VAleSh-Soft/tda7339_to_tda7439/docs/VTCD-800_s_m.pdf

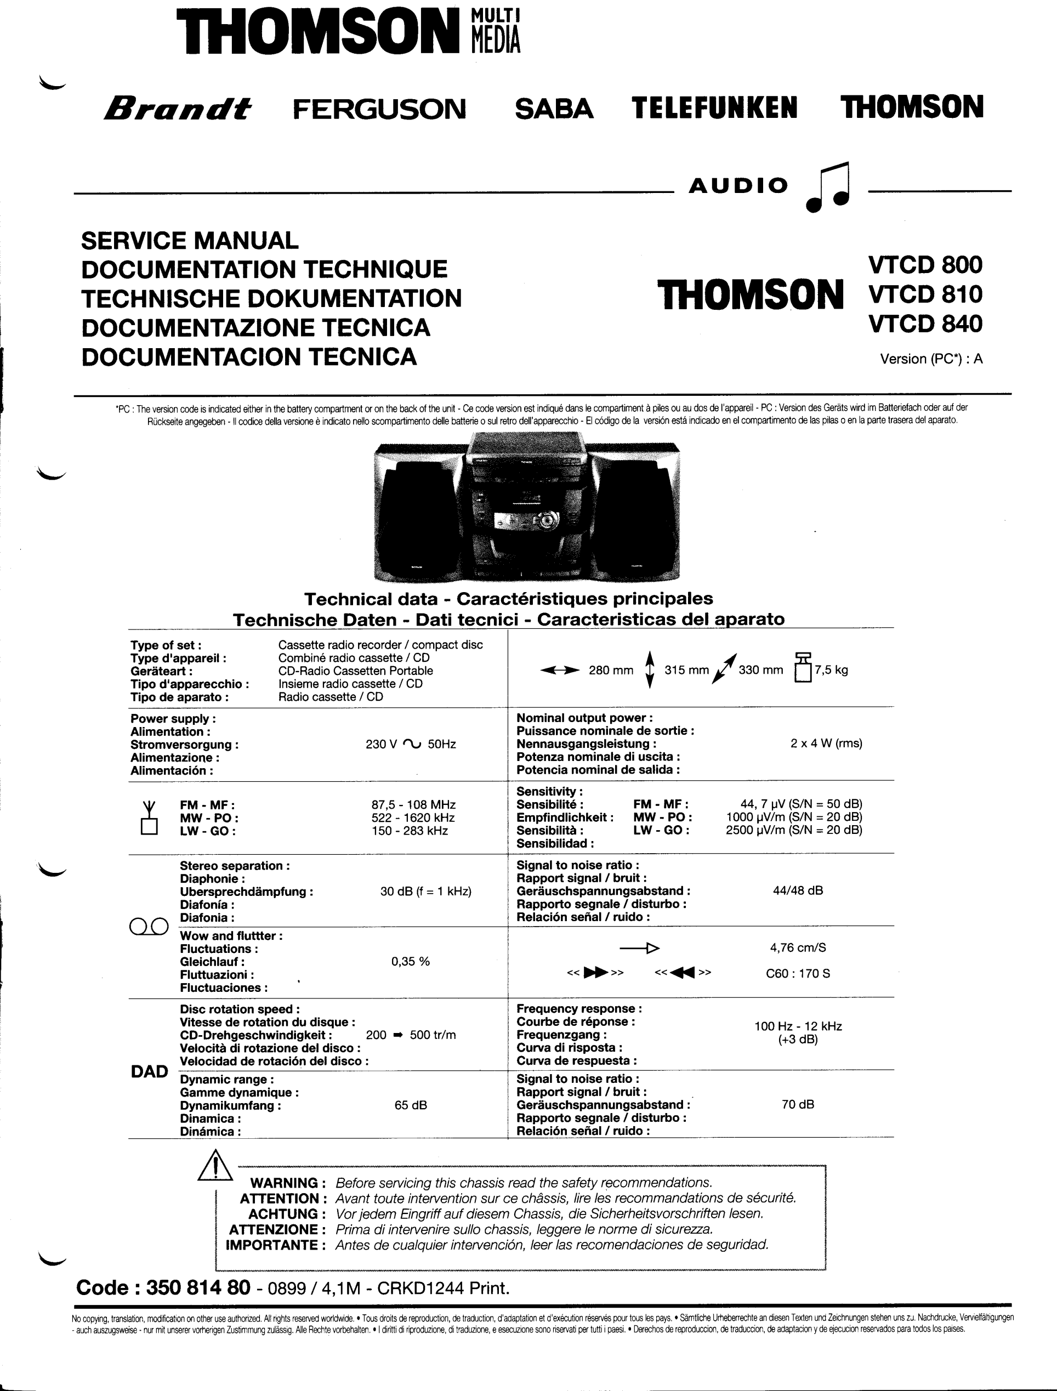
[picture p11: page 1]

# MAIN SCHEMATIC DIAGRAM - SCHEMA DE LA PLATINE PRINCIPALE - SCHALTBILD HAUPTLEITERPU ESQUEMA DE LA PLATINA PRINCIPAL

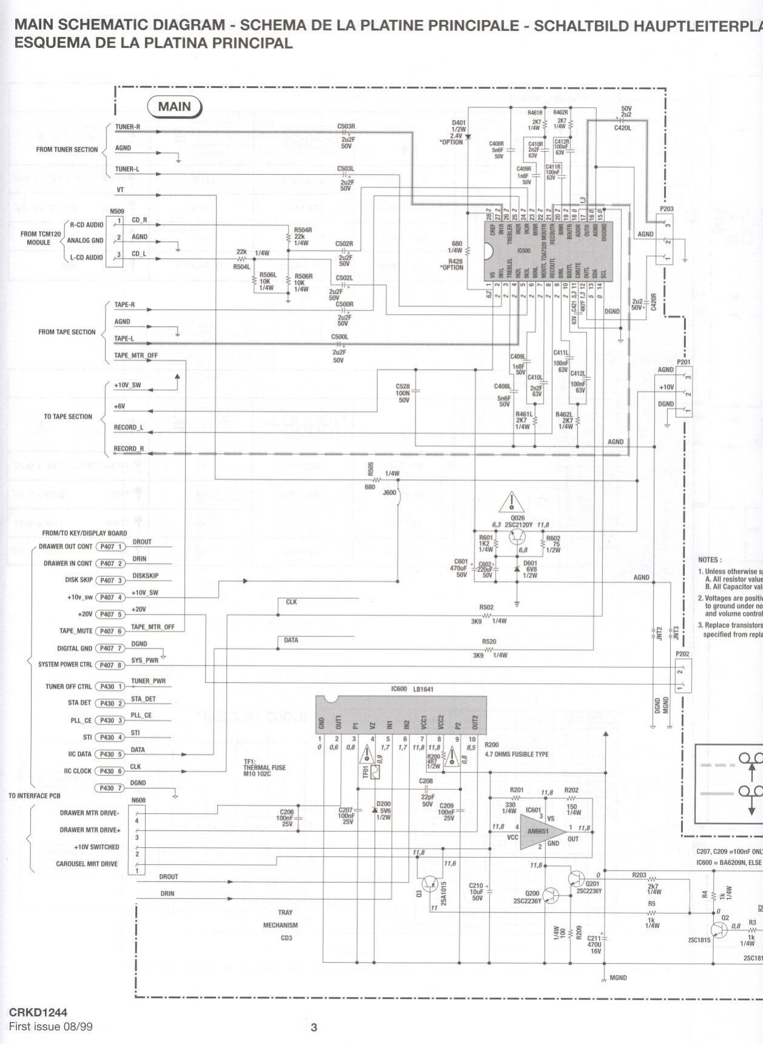
[picture p12: page 2]

'-':'-', I | ~'"- | . I

_
I
( MAlN ) | 0401 | 1/~~ | 1/~~ | C420L | -
C R | 1/2W | I 2.4V | -
{
TUNER.R | 2u2F | 'OPTION | C4()8R
I SOV | 5n6F
5OV | . FROMTUNERSECTlON | AGNO | . 1 | 1 - | ~a | -
TUNER.L | . | ~U2F | I VT | SOV
{
R'COAUUlO
FROMTCM120
MOOULE ANALOGGNO

L-COAUUlO

N509
11 CO_R

AGNO

CO_L

FROM TAPE SECTION
{

TAPE.R

AGNO

TAPE-L

TAPE_MTR~FF

(

+10VSW - | . +6V TO TAPE SECTlON

RECORD_L

RECORI!~R

FROMITO KEYIUlSPLAY BOARD
DRAWEROUTCONT~

DRAWERIN CONT~

UlSKSKIP ~ +10v_sw ( P407 4) +10V_SW

+20V (P407 S +20V

TAPE_MUTE( P407 6) TAPE_MTR_OFF UlGITALGND~ SYSTEMPOWERCTRL( P407 8) SYS]WR

TUNEROFFCTRL( P430 1) TUNER]WR

STADET ( P430 2) STA_DET
PLL_CE~

STI~
IICDATA( P430S~A
IIC CLDCK( P430 6~
~ TOINTERFACEPC8 | - N608 | .&

{

DRAWERMTRDRIVE.

ORAWERMTRDRIVE+

+10VSWITCHED

CAROUSELMRTDRIVE

660
1/4W
R428 'DPTION

DGND

I

.. 1

2u2-l-re - sov+r3 I

'-'1

1

I
P201
AGND

~
~

1

2U2F
SOV

CSOOL

00
ZZ

""" o,,"

R203
-m- 2k7
1I4W
RS

1k
1I4W

MGND

,-.-.-.-.-

C207, C209 =1 oonF ON~
IC600 = BA6209N, ELSE

~ ;: ~~

2u2F
SOV
j | CS28
1ooN
SOV | Sn6F
SOV

N

1k 1I4W

2SC181

## CRKD1244 First issue 08/99

R461L 2K7 : 1I4W'

R462L 2K7
1/4W

'"
"
~ | 1I4W
680 J600 | &0026

6,3 2SC2120Y11,8
R601 | fi | 602 1K2 | 7S 1/4W | 6.8 | 1/2W
C601 +1 C60~,-- 470uF | 'f22~ilÍt s8vT

### SOV~

0601
6V8
1I2W
CLK | RSO2
| 3K9 1I4W
DATA | RS20 -.f#--- 3K9 1/4W

TF1:
THERMALFUSE M10 102C
11,8 | R202
IC600 | L81641

R2oo

4.7 OHMS FUSI8LE TYPE

C2OS
R201

C206
100nF- 2SV

C207'
100nF
2SV

D2oo
,SV6
1I2W

22pF
SOV C209
1OOnF 2SV

1S0
1/4W

11,6
DROUT
C210 +
10uF
SOV ORIN

TRAY
MECHANISM
C03
1 AGND j I | 1

I
I
1
I
I

1 NOTES:

AGNDI | 1 1.Unlessolherwlse SI A.Aliresislor value I B.AliCapacilor vali

I 2. Vollages are posilh
lo ground under no
and volume conlrol
N | ),M 1 | 3. Replace Iransislors
X"" X"" - | specified from repla
.;; | y;; I
| P202

RS04R
22k
1I4W CS02R
22k 1/4W

RS06L t RS06R
10K | 10K 1/4W | 1/4W

# LTBILDHAUPTLEITERPLATTE - SCHEMA PIASTRA PRINCIPALE-

1--'-'-'-"'"

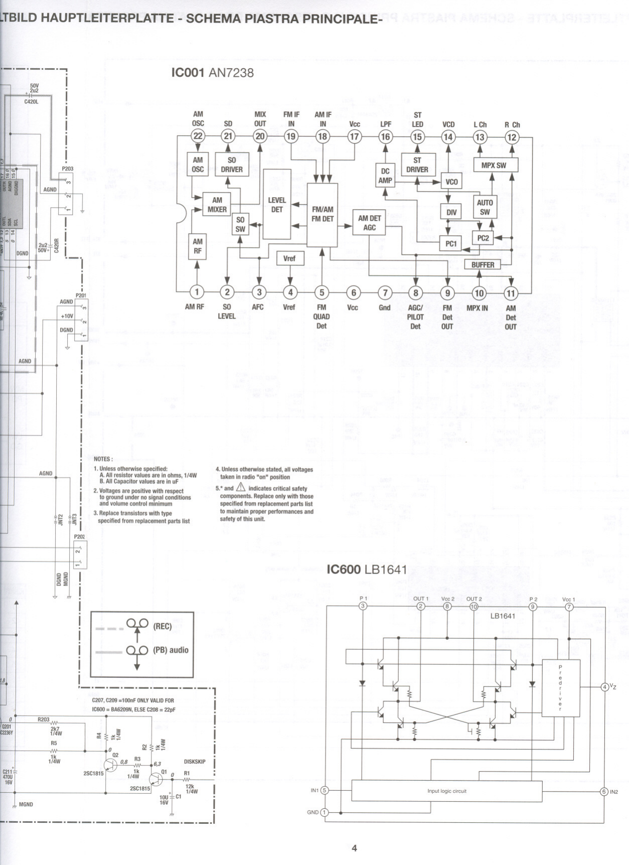
[picture p13: page 3]

I

1
I
I

1
I

50V
2u2 "'!~

C420L

# ICOO1AN7238

I
P201
AGNO
'<O1R101- | I | 12k ~ | êL | 1 1I4W 1011 C1 | . MGNO | 16VI !

:>1"'1<>
~ DGNO
/
íI

I
AGNO

~

o Vâ1Ot

~2236Y

C211~
47DII
16V

I

. 1'" I 2u2 ~ - 50V.;["C$ 1

'-',

1

AGNO

R203
--vvv2k7

1I4W
R5

1k
1I4W

AMRF SO
LEVEL
AFC | Vref | FM
QUAD
DeI
Vcc | Gnd | AGC!
PILOT
DeI

FM
Det
OUT

MPXIN AM
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
~'" ÀM I
X~ ~~ i
| P202

NOTES:
I, Unlessolherwisespecilied: A.Aliresislorvaluesarein ohmso1I4W B.Ali Capacilorvaluesarein uF 2.Vollagesareposilivewilh respecl
lo groundundernosignalcondilions andvolumeconlrolminimum

3,ReplaceIransislorswilh type speciliedIromreplacemenlparIslisl

4.Unlessolherwiseslaledoali voltages laken in radio"on" posilion
6,* and .6 indicales crilical salety

components.Replaceonlvwilh Ihose specifiedIrom replacemenlparIslisl lo mainlainproporpertormancesand salety01Ihis unil.

CC
ZZ """

c:; I
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
OISKSKIP I RI

# IC600 LB1641

P 1
'3i

P2
9)

Vcc 1
'7
LB1641

## ar(REG)

ar(PB) audio

4jVz

C207, C209 =100nF ONLY VALlO FOR

IC600 = BA6209N, ELSE C2OS = 22pF

;::
~! | ;::
~ ~~!
Inputlogic | circui! | 6) IN2

# MAIN SCHEMATIC DIAGRAM - SCHEMA DE LA PLATINE PRINCIPALE - SCHALTBILD HAUPTLEITERPL (TUNER PART)

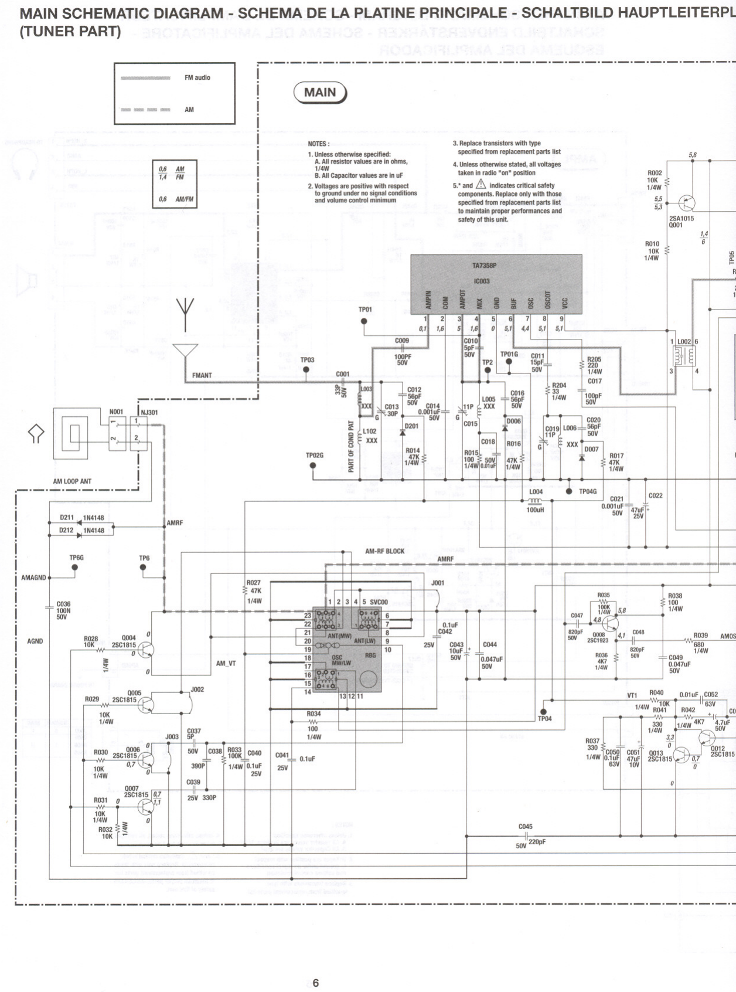
[picture p14: page 4]

«

----- FMaudio

AM

0,6 AM
1;4 FM

0,6 AMIFM
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
~ | ~
INJ301
f

0211
0212

1N4148
1N4148

AMRF

o

RO29

AM_VT

# ( MAIN )

NOTES:
1. Unless olherwise specilied:
A. Ali resislor values are in ohms, 1I4W
B. Ali Capacilor values are in uF
2. Vollages are posilive wilh respecl lo ground under no slgnal condilions and volume conlrol minimum
3. Replace Iransislors wilh type specilied lrom replacemenl paris lisl
4. Unless olherwise staled, ali vollages laken in radio "on" posilion
5.' and ,1; indicales crilical salety componenls. Replace only wilh Ihose specilied Irom replacemenl paris list lo mainlain propor perlormances and safety 01Ihis unil.

R205
220
1I4W
CO17

1~~t

C020
S6pF
SOV
XXX T0007

5,8

RO02
10K
1I4W
5,5
5;3
2SA101S
0001

R010
10K
1I4W

M6
"'
~
I-
RI
,
1,

RO17
47K
1I4W

LOO4
TP04G J C0211 1 C022 0.001uFI47uFT+

SOVI"2SV

ROAO
VT~1/4W R041

0.01uFI

~
COS2
63V
~ | tO!

1/~W j1l4W4K,~ ~~.JF
3,3
O- R037
33°i'COSO

I

cosiI ⁰⁰¹³ 1I4W10.1uF 47uF 2SC181S 63V 10V

TP6G | TP6 I
AMLOOPANT | ! .-,-,-,-,-,-,-,...1
I
I
I
I
I

iAMAGNO
I
I
I
i AGNO
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
CO36
100N
SOV

R028

10K | 0004 2SC181S
| li
!

10K
1/4W

R030 2S 0006 O
~10K | 0,7 1I4W | -O

0007
2SC181S10,7
JJ R031
-IW-10K
1I4W
R032

10K !

C037
~ | RO33 CO40 5OV C038 100K.r
WTo.1uF 390Pr | 1/4 | 2SV
C039

2SV 330P

O

TP03

TP02G

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
1I4W

L102
XXX

0201

R014
47K
1I4W

100uH

AM-RF BLOCK
AMRF

R027
: 47K

1I4W

TPOA

JO01

0.1uF
C0A2
2SV | CO44 f8:~ 1+ SOV | 0.047uF

SOV

R034
-w.-
100
1I4W

C041
2SV

0.1uF

COAS

SOV220pF

# MAIN SCHEMATIC DIAGRAM - SCHEMA DE LA PLATINE PRINCIPALE - SCHALTBILD HAUPTLEITERPL (TUNER PART)

«

----- FMaudio

AM

0,6 AM
1;4 FM

0,6 AMIFM
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
~ | ~
INJ301
f

0211
0212

1N4148
1N4148

AMRF

o

RO29

AM_VT

# ( MAIN )

NOTES:
1. Unless olherwise specilied:
A. Ali resislor values are in ohms, 1I4W
B. Ali Capacilor values are in uF
2. Vollages are posilive wilh respecl lo ground under no slgnal condilions and volume conlrol minimum
3. Replace Iransislors wilh type specilied lrom replacemenl paris lisl
4. Unless olherwise staled, ali vollages laken in radio "on" posilion
5.' and ,1; indicales crilical salety componenls. Replace only wilh Ihose specilied Irom replacemenl paris list lo mainlain propor perlormances and safety 01Ihis unil.

R205
220
1I4W
CO17

1~~t

C020
S6pF
SOV
XXX T0007

5,8

RO02
10K
1I4W
5,5
5;3
2SA101S
0001

R010
10K
1I4W

M6
"'
~
I-
RI
,
1,

RO17
47K
1I4W

LOO4
TP04G J C0211 1 C022 0.001uFI47uFT+

SOVI"2SV

ROAO
VT~1/4W R041

0.01uFI

~
COS2
63V
~ | tO!

1/~W j1l4W4K,~ ~~.JF
3,3
O- R037
33°i'COSO

I

cosiI ⁰⁰¹³ 1I4W10.1uF 47uF 2SC181S 63V 10V

TP6G | TP6 I
AMLOOPANT | ! .-,-,-,-,-,-,-,...1
I
I
I
I
I

iAMAGNO
I
I
I
i AGNO
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
CO36
100N
SOV

R028

10K | 0004 2SC181S
| li
!

10K
1/4W

R030 2S 0006 O
~10K | 0,7 1I4W | -O

0007
2SC181S10,7
JJ R031
-IW-10K
1I4W
R032

10K !

C037
~ | RO33 CO40 5OV C038 100K.r
WTo.1uF 390Pr | 1/4 | 2SV
C039

2SV 330P

O

TP03

TP02G

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
1I4W

L102
XXX

0201

R014
47K
1I4W

100uH

AM-RF BLOCK
AMRF

R027
: 47K

1I4W

TPOA

JO01

0.1uF
C0A2
2SV | CO44 f8:~ 1+ SOV | 0.047uF

SOV

R034
-w.-
100
1I4W

C041
2SV

0.1uF

COAS

SOV220pF

# ~LTBILD HAUPTLEITERPLATTE - SCHEMA PIASTRA PRINCIPALE - ESQUEMA DE LA PLATINA PRINCIPAL

..- | 1. 6v

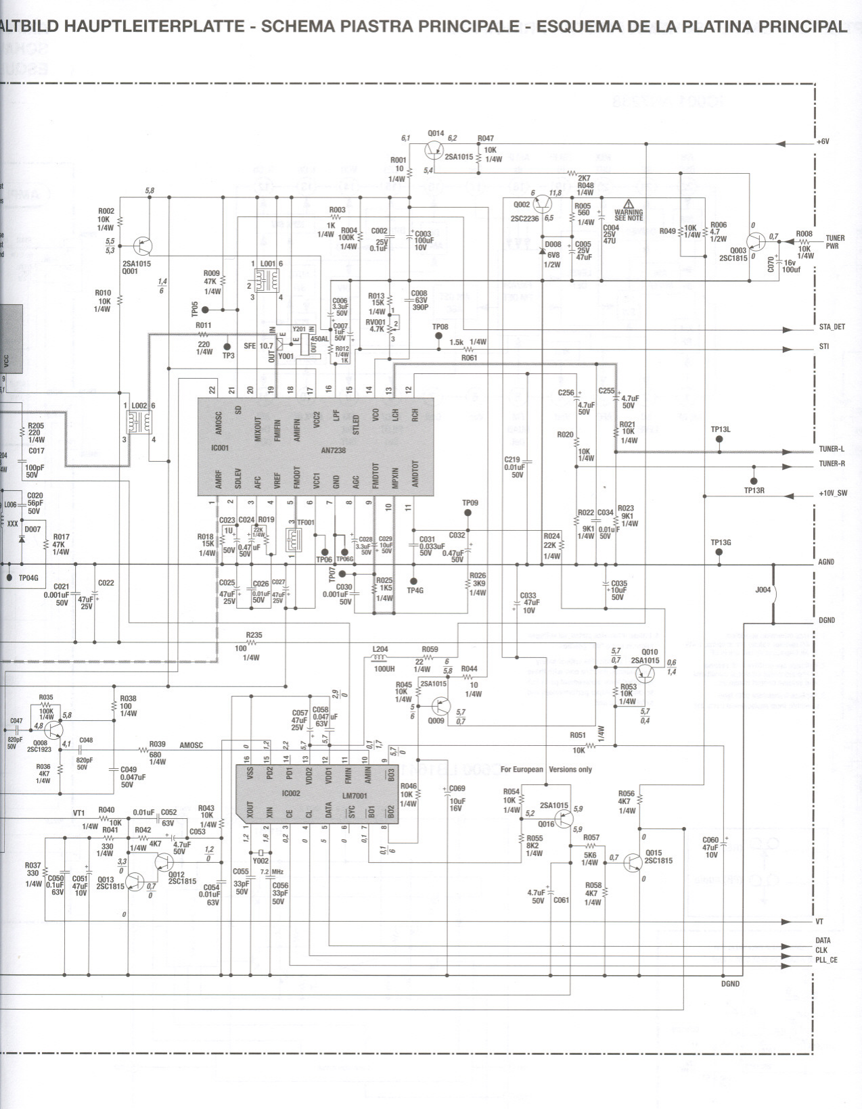
[picture p15: page 6]

~
F

5,8

RO03
-'Mr-1K RO04 1I4W1ooK
1I4W

~
"
~

R002
10K
11-;1 d
5,3~
2SA1015
0001 | RO09
47K:
1/4W

1 LO0116

2 | Ilê
3 | 4 R010
10K
1/4W

1,4
li
f~....
R011
220 . 1/4W TP3
~ | N ~ | :2 :: !---
11~6

~II~
3114

R205
220
1I4W

!04 ..L CO17

~W T1~~F

---<

r l C020

.llOO6..l56pF
T50V
XXXt;;;-;
- N | '" | .. | ..,
,
| | | .'TFO01
~II | ; 33uF

# - Jll~ RO17

47K
1I4W

1 ;P04GJ C0211 1 C022

0.001 uF 147uFT+
50V 1"25V
~... C0251 ~026 CO27tLI:=C03~ 47uF+ O.O'uF07uF+ | 0.001uFT 25V | 50V 25V | 50V1

R235
---wv-100
1/4W

*C0490.047uF
50V

R039
6ãO
1I4W | ~

RO38
100
1I4W | C057

I

C058

1

47uF 0.047uF 25V 63V

## AMOSC '" ~::f~)'~ :2 :2 ;! ~

r

VT1 R040 | 0.01uF C052
10K | 63V | _
14

M

1/4WR041 | R042 | " '" " 330 | 1/4W4K7 4.7.}'F 1,2 | -' | ~ | '"
1/4W | 50 | O' | VO02
32 | C055 7.2MHl O | 0012
~ ⁰⁰¹³ | 2SC1815 C05

~ 33P
T

C056
2SC1815 | 0.01uF | 50V | 33pF
63V | 50V

'"

.. "'
'"

R037

~

..l , 330 COSO C05i 1I4W 0.1uf 47uF 63;;1 10V

o

6,1 | R047
10K
RO01I | 1I4W
10 } 1I4W | 2K7
RO48
1I4W
ROO5
560 +
1/4W
R049~1Y:W | TUNER
PWR

6 11,8
00O2iGt'
2SC22~5
Coo~
25V1
0.1ufl

&.
~AR~b~~
> | 1 | I

CO04

,0008 1CO05 ~~H
6V8 T²⁵V
1/2W 47uF

~

RO06 | O
1i1w | 0,7 | RO08
0003 | 10K 2SC1815O ",+ | 1I4W
8T11J~uf | :
I
I

## ISTUET

+CO03
100uF
10V

Rf~~
~

### JEg~

1I4W 1 T390P
RVO01 2 4.7K

3

TPO8

~4W | RD61 | I
I
I
I
I
TUNER-L

STI

~ | ~ | ;! | ~ | C2561+

I

C255i.
, | :f4.7UF
4.7uF | S 50V 50V

R020

+ R021
10K
1I4W

TP13L
, C219-"-- 0.O1uF' 50V

10K
1/4W | TUNER-R
TP13R | +10V_SW .... | TP09 | ...-- ao | :: | _R022IC034

~

R023

::.J.: | 9K1
9K1Tõ.O1u F 1/4W
1I4W!SOV | TP13G
!

I
I
I

AGND

--LC031 C032 -.O.033uF 1+ 50V 0.47uF' 50V

R024
22K:
1/4W

TP4G

R026
:3K9
1/4W | JoJ

I
I

I DGND

C035
+10uF CO33 | 50V 47uF +1 10V | í L204

22d6

1I4W 5]j R044
R045 2SA101S | 10
10K | 1I4W 1I4W
~ | 5,7
6 | 0009 OJ
~

100UH

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
~I",

:: J1~F'"

R046n
~

+ CD69
10K | T10UF 1/4W | 16V

R051
10K
For Europa." I Varsio". | o"IV
'" | 00

R054

10K'f | 2SA1015 59 1I4WI5,2 | '
0016
R055
8K2 | 0015 1I4W | 2SC1815
R058 4.7uF+.L | I
4K7: 50VTC061 | 1I4W

CO60 1+
47uF
10V

R056
4K7
1I4W
'" ;;,
;;-1«>

DAr.
CLK
PLL_CE
I
I
I

DGNO

# ~PRINCIPAL

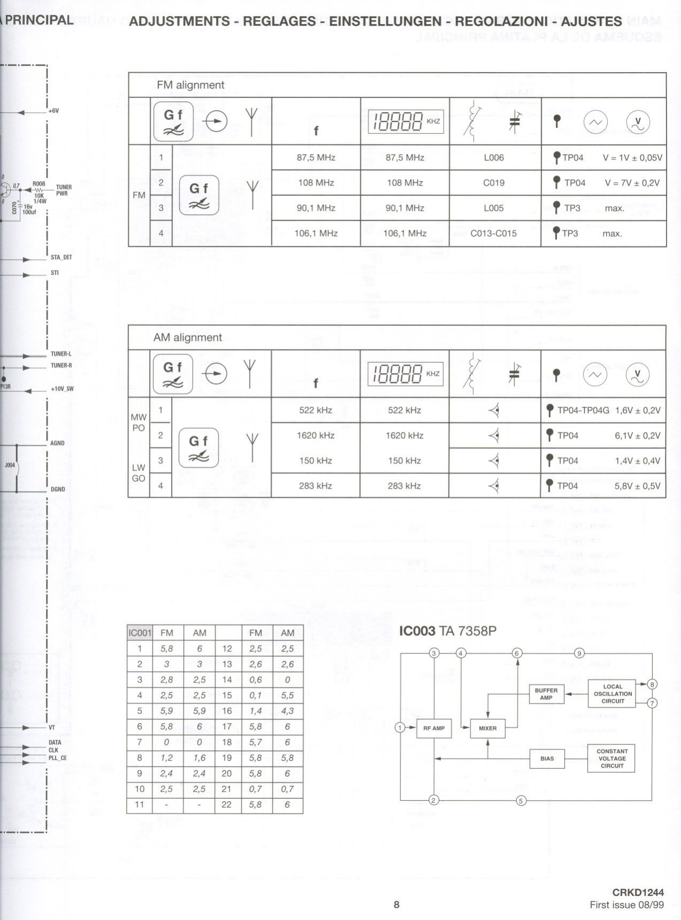
[picture p16: page 7]

I
I
I
+6V

RODa TUNER
PWR

# . ISTA_DET

# . STI

-+

I
I
I
I
I

.TUNER.L

TUNER.R

~

P13R .. +1UV_5W
I
I
TI | : AGND
JOO4 | .
I
| I DGND

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
. DATA
CLK
PLL_CE
I
I
I
I .-.

# ADJUSTMENTS - REGLAGES- EINSTELLUNGEN - REGOLAZIONI - AJUSTES

# ICOO3TA 7358P

9

2 | 5

## CRKD1244

## First issue 08/99

# FMalignment

[JB r | f | I"IC/C/C/C/ /I/IIn KHZ I

f #

'
G (1)
1 | 87,5 MHz | 87,5 MHz | LO06 | 'TP04 | V = 1V :J: 0,05V -

2
(] | r
| 108 MHz | 108 MHz | C019 | 'TP04 | V = 7V :J:0,2V
FM -
3 | 90,1 MHz | 90,1 MHz | LO05 | 'TP3 | max.
4 | 106,1 MHz | 106,1 MHz | C013-C015 | 'TP3 | max.

## AM alignment

[]-8 | r | f | I'' IC/UUU IUUU KHZI
k #

'
G (1)
1 | 522 kHz | 522 kHz | -<i MW | 'TP04-TP04G | 1,6V:J:0,2V
PO -
2
[] | r
1620kHz | 1620kHz | -<i | , TP04 | 6,1V:J:0,2V -
3 | 150 kHz | 150 kHz | -<i | 'TP04 | 1,4V :J:O,4V LW
GO -
4 | 283 kHz | 283 kHz | -<i | 'TP04 | 5,8V :J:0,5V
;t() | FM | AM | | FM | AM
1 | 5,8 | 6 | 12 | 2,5 | 2,5
2 | 3 | 3 | 13 | 2,6 | 2,6
3 | 2,8 | 2,5 | 14 | 0,6 | o
4 | 2,5 | 2,5 | 15 | 0,1 | 5,5
5 | 5,9 | 5,9 | 16 | 1,4 | 4,3
6 | 5,8 | 6 | 17 | 5,8 | 6
7 | o | o | 18 | 5,7 | 6
8 | 1,2 | 1,6 | 19 | 5,8 | 5,8
9 | 2,4 | 2,4 | 20 | 5,8 | 6
10 | 2,5 | 2,5 | 21 | 0,7 | 0,7
11 | - | - | 22 | 5,8 | 6

## MAIN SCHEMATIC DIAGRAM - SCHEMA DE LA PLATINE PRINCIPALE - SCHALTBILD HAUPTLEITERPLAT

## (TAPE PART)

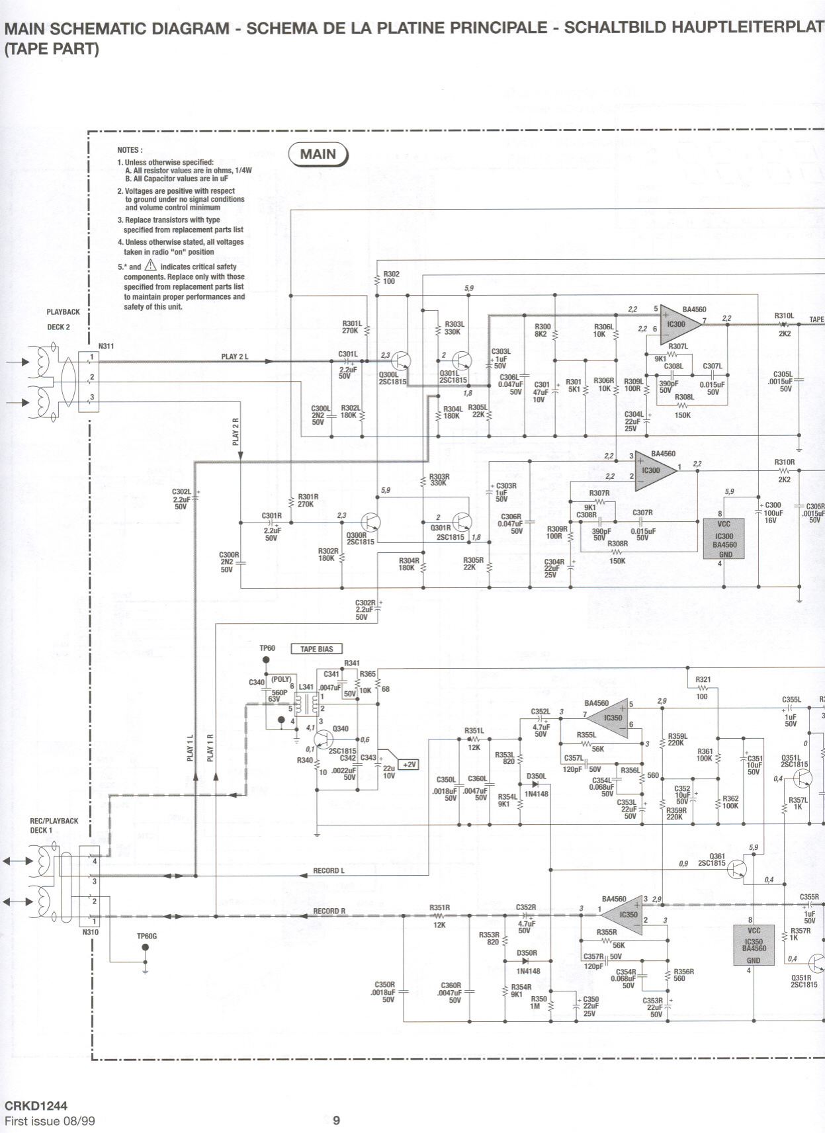
[picture p17: page 8]

NOTES:

1. Unless olherwise specilied:
A. Ali resislor values are in ohms, 1/4W
B. Ali Capacilor values are in uF
2. Vollages are positive wilh respecl
lo ground under no signal condilions and volume conlrol minimum

# ( MAIN)

I
I

# L._._._.-.-.-.-.-.-.-.-.-.-.-.-.-.-.-.-.-.-.-.-.-.-.-.-.-.-.-.-.-.-.-.-.-.-.-

## CRKD1244

First issue 08/99 | 9

R302
100
5,9
22 | BA4S60 | R310l >--
"7 | 2, | TAPE R301l | R303l | R300 | R306l | 2,2 6 | 2K2 270K | 330K | 8K2 | 10K
C301l | C303l | .07l 2,3
9K1 | 1
"I Á | .--, | PLAY2 l | luF
Q30;;0 | Cp8l | C3,97l SOV
.08fg==
\ | 2.2uF | C306l= | R306R R309l

lijO;F

0.015UF

SOV
+ R;11
2 | 2SC181 | 2SC181S | 0.047uF C301 | 10K | I00R | SOV | SOV 1,8 | SOV 47uF | R308l / | 3 | 10V
R302l | R304l R30Sl | C304l + | IS0K C300l v
3= = 180K | 180K 22K o: | 22uF
2SV I | N
5... I | 2,2 | 3 | BA4560
R310R 1 2,2 I | R303R | 2,2 2 | 2K2 330K | +C303R
I | C302l | 5,9 | luF | R307R R301R

2J

### SOV

+ F =

:=C30SR

2.2uF | 270K | 9K1
Cp7R | .001SuF I | 5OV
2,3 rv | C306R | C308R | 16V | SOV C301R
0.047uF I | 2.2F | O.O'SuF

Q3o.t:l

Q301 | SOV | R309R
2SC1815 1,8 | 100R | 390,pF
50 R308R 50V | 50V 2SC1815 I | R302R
150K C300R | 180K
l8:R i< | R305R | C304R + I | 2N2 *= | 22K | 22uF

50V I

25V
I
I | C302R+ 2.2uF

50V I

I | TP60 I TAPEBIAS I
I | 4 | R341

C340 (POiY)
C3:t
R365 I | ==, 6 | .0047uF 10K 68
100 I | C355l | R:
6euP5 II

1 50V
: | " | +luF
2 | C352l 3 | 3
50V I | 3
4,1 | ÚF R351l | 50V | R355l | R359l I | 3 | 220K | O .... o: | 0,6 | 12K | 56K | R361
+C351 Q351l 5 5 | 0,1 2SC1815 | R353l I | C342C343 | 820 | C357':JL | I00K | 10uF | 2 ... ... | R340

10 .OO22uF
120pF "50V | L
50V 0350l | 560 I | D.4 ⁵⁰V | 10V | C350l | C360 1=

148

C354l
.0018uF | 0.068uF | C352 0047UF | " R354l | 50V | \'if; + | R362 | R357l I | 50V | 50V | C353l + | 100K | IK

1

9K1 | 22uF | R359R I | 50V | 220K EC/PLAYBACK
I ECKI | - | 5,9
Q36 4 | 0,9 2SC1815
RECOROl
3 | 0,4
' r- | C355R
:.51R | C352R | 3 RECOROR | luF
2 | 3 | 8 | 50V 12K | 4.7uF | R357R
1
50V | R355R | IK
-=:: | TP80G | R353R
820 | 56K
Li | 0350R | C357R"50V
IN4148 | 120pF" C354l | R356R | 4 560 | Q351R C350R | C360R | O.068UrL | 2SC1815 i<R354R | 50V
.0018uF =r= | .0047uF =r= | 9K1 R3500 C350 | C353R 50V | 50V | + IM
T22uF | 22uF 25V | 50V

# ICHALTBILDHAUPTLEITERPLATTE - SCHEMA PIASTRA PRINCIPALE - ESQUEMA DE LA PLATINA PRINCIPA

I

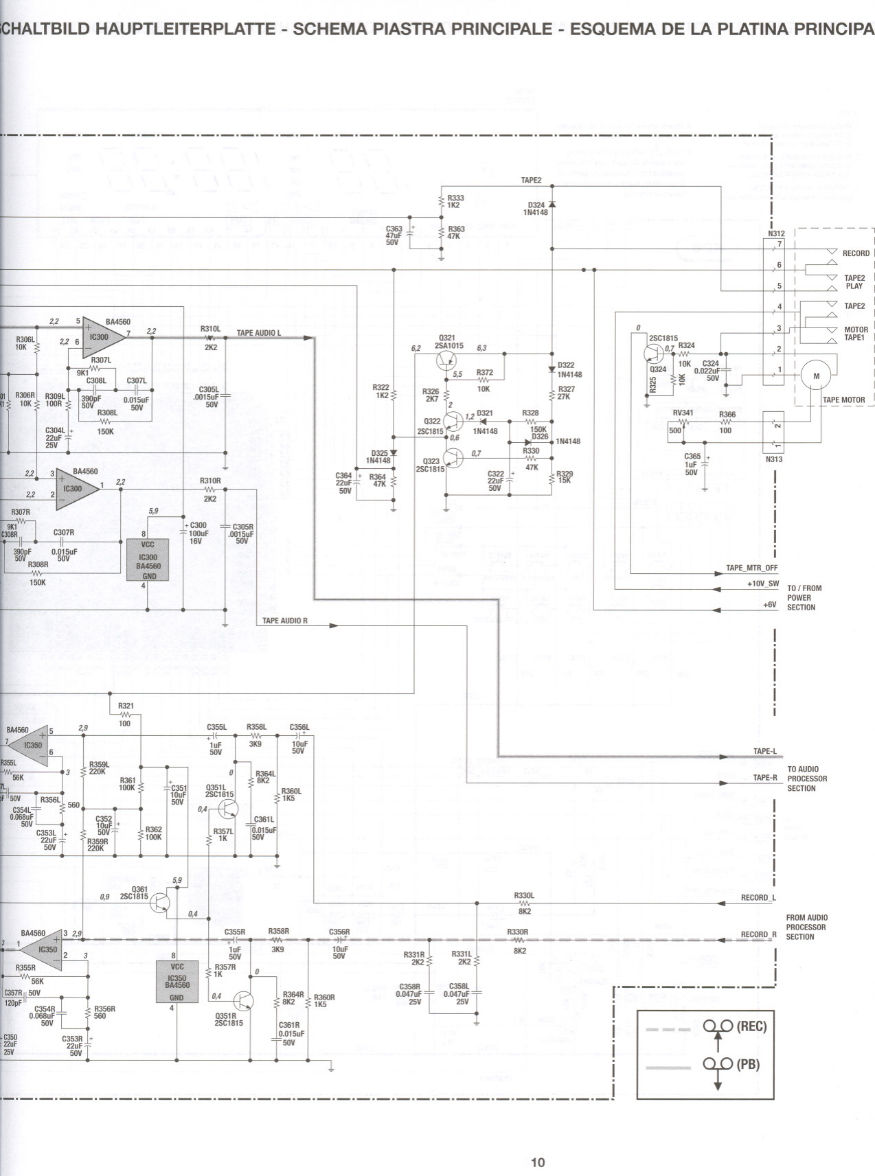
[picture p18: page 9]

~

I
I
,'-'-'-'-'-'-'-'-'
I
I
I
I

R333
1K2

C363 1+ 47uF
50V

R363
47K

R306L
10K

2,2

~ I R306RI R309L
I1$ | 10K$ 100R
C304L | 1+
22uF
25V

150K

2,2 | 8A4560
1 | 2,2
2,2
~ ~.
~~O7R
nqyF o.ot; 50 R308R 5OV

150K

TAPE | AUDlO | R

~64R~ ~~~OR

C358R..l C358L-0.047UFT 0.04J~~T
25V=

10uF

50V 3K9 | R331R 2K2 | R331L
2K2

C354R
O.068uF 50V

R356R
560 | 0351R
2SC1815 | C361R
O.015uF
-50V ~C350
i 22uF
25V

C353R 1+
22uF
50V

TAPE2

0324
1N4148

R330L
--'Wv--
8K2

R330R

8K2

~
1;1

I
I
I
~312 I | l
71 I | I RECORO I

I
TAPE2I
PLAY I
TAPE2I
I
MOTORI
TAPE1I
I
I
I
I
I
RV341 R366
-0N-100

N313

TAPE_MTR_OFF

+10V_SW TO/FROM
POWER
+6V SECTION

TAPE-L"

TO AUDlO

TAPE-R | PROCESSaR SECTION

RECORO_L

FROM AUOIO

PROCESSaR

RECORO_R | SECTION

# ar (REG)

~ (PB)

2,_2 | R310L
Wi- r.HIPIAUDlO,L "'; | I
0321
2K2 | 62 | 2SA1015
-------,
0322

C305L..l
I R326 rv

1N4148
.0018T | I | R322f ¹K2 | R327
2K7 | 27K
2 | R328
-wr---- 150K

1N4148
| | | 0325 | | R330
| | | 1N4148
I | 0323 R310R | C364 | R364 | 2SC1815 | 47K
I

R329
| | 8T | 47K

15K
2K2
5

+ C300
T C305R
100uF | .OO15uF
16V | 50V

R321
-wv-
2,9 | 100 I | C355L R358L C356L
-------.1 | 1uF | 3K9 | 10uF 50V | 50V

R359L 220K
J f3641
R361 | 8K2 R360L 100K | 0351L 2SC1815 | 1K5

C352

lR;1 | ..lC361 L I
10uF + | R362
1.015uF 50V
R359R | 100K | 50V
220K

5,9
0361
0,9 2SC1815
C355R | R358R | C356R+

# OUDISPLAYSCHEMATICDIAGRAM- SCHEMACOMMANDES/AFFICHEUR- SCHALTBILDBEDIENTEIL/ANZEIGE

I

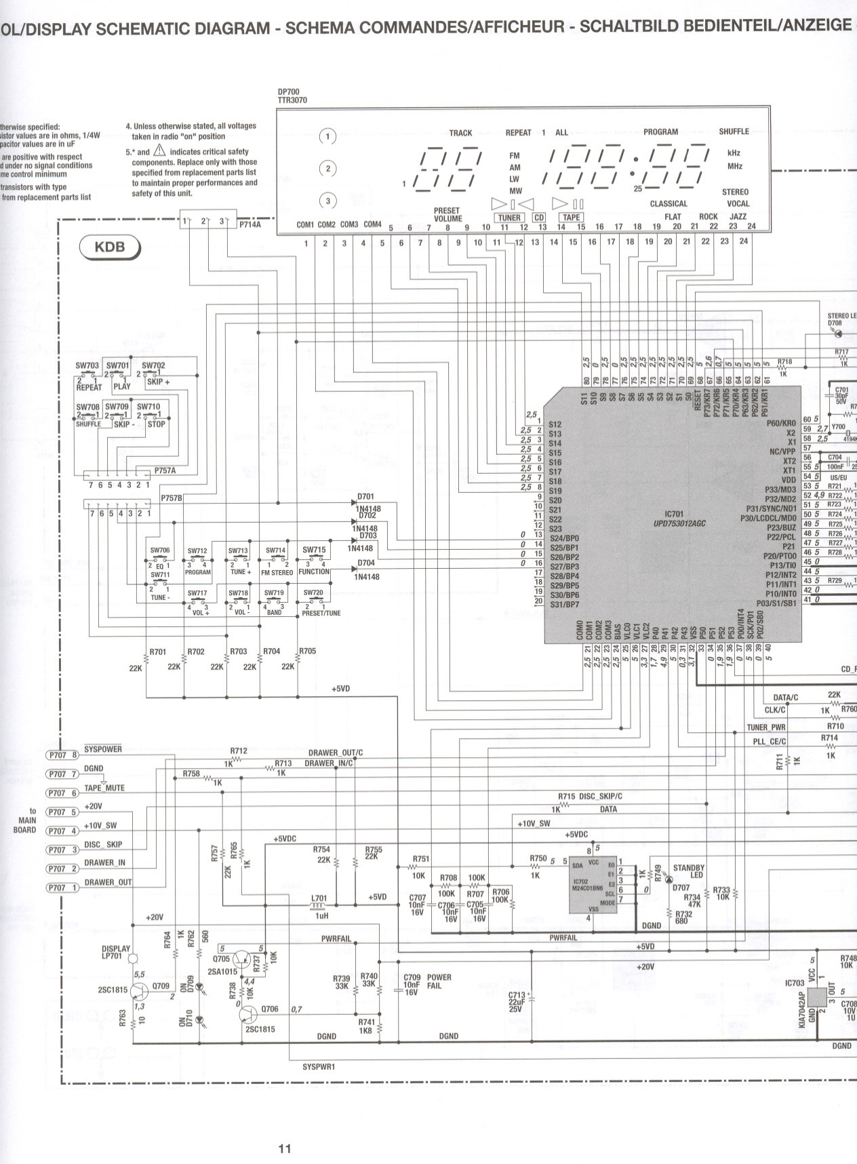
[picture p19: page 10]

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
! | SYSPWRI L______.-------.-------.-----.-------.-.-----.-------.-------.-----.-----.-.---.-

Iherwisespecilied:
;istorvaluesare in ohms,1/4W pacitorvaluesarein uF
areposilivewilh respecl
dundernosignalcondilions meconlrolminimum

transislorswilh type
fromreplacemenlparis lisl

lo
MAIN
BOARO

4.Unlessolherwiseslaled,alivollages laken in radio"on" posilion
5.' and& indicales crilical salelv

componenls.Replaceonlvwilh Ihose speciliedIrom replacemenlparis lisl lo mainlainproperpertormancesand salety01Ihis unil.

### 11 I

! (KDB)
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
P757A
7654321
P757B
R701 | ~R702 | ~R703 ~R704 | JR705
22KI | 22K1 | 22K1 22K1 | 22K

P707B) SYSPOWER

(P707 7) OGN~
P707 6) TAPE_MUTE

P707 5' +20V

R712
jj("-
R75B
IK

P707 4) +10V_SW
P707 3' DlSC-SKIP | iB... o: ...
'"
... o: ;!: 1>7072) ORAWER_IN

P707 l' ORAWER_OUT

'"NN

+20V

DlSPLAY
LP701

;g I
;!:~ l

# ã! ... ...'" o: o:

2SC1B15
~ 1

1,3

## ... c o: - c

",1:
cc | 2SC1B15

OP700
TTR3070

(1)

(2)

(3)

COM1COM2COM3COM45
4 I 5 I

STEREO LE
0708

+5VD

CD_I

DATAlC

## CWC

TUNER]WR
PLL_CElC

22K
IK~
---wr
R710
R714

R713
li(

DRAWEROUT/C
DRAWER_IN/C | ~~;!:

IK

R715DlSCSKIP/C

## 1li""" - DATA

+10V~SW
+5VDC

R733
10K

R754
22K

R755
22K | R75055
| w.,-=-
| IK

R751
I./--
10K R70B1 100K

STANDBY
, LED D707 .

R734: 47K
R732
6BO
L701 | +5VD | C707-.lI OOKl R7071R706
10nFT c706 C705"uOOK 16V | 10nFl 10nF 16Vl 16V | DGND
luH
PWRFAIL | PWRFAIL
+5VD
R748 +20V | 10K

## Rlli l ~1'1f C709POWER

10nFFAIL 16V | 5

'" C7OB
10V
lU

C713+
22uF
25V | ~
g...
""
Si:

0,7

DGND

R741
IKB | DGND
DGND

11

TRACK REPEAT1 ALL

# I 11 I - - - 1 I 11 I

PRESET
VOLUME 6

PROGRAM SHUFFLE

I .I 11 I kHz
- - | MHz | ,.....----.--- I .I 11 I

# ,CHALTBILDBEDIENTEIL/ANZEIGE - SCHEMA COMANDI/INDICATORE - ESQUEMA MANDOS/INDICADOR

P717 7654321 -.-.-.-.-.-.-.-.-.

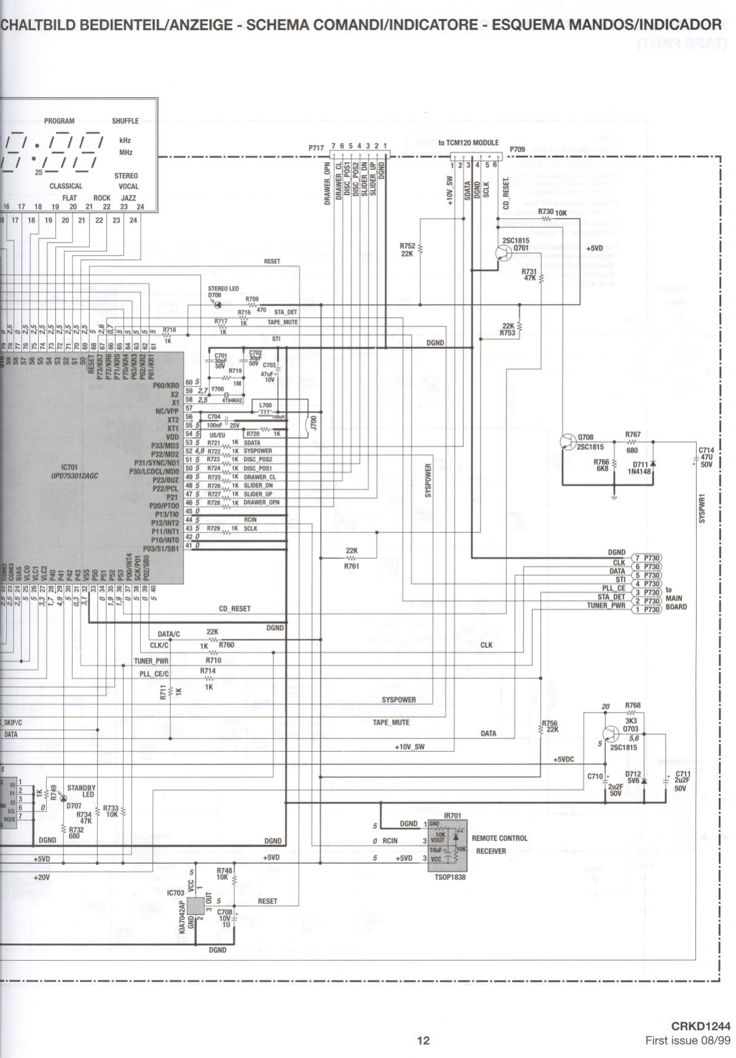
[picture p20: page 11]

PROGRAM | SHUFFLE
- | - - 'I /. / - | - V / 1-
- /
I

## kHz

MHz

li!!

~

1

!':i

l

reJ~I:i!

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
~I~ I

!:;l

gjl

gJl
~
;,~I~"'I"'::}:::~"'~;;;- "'~~.""""""

DATAlC
~'-----

TUNER_PWR
PLLCE/C

SKIP/C
DATA

~"I STANDBY
!i:~ LED D707 R734 47K R732

DGND ' 680

R733
10K

+5VD

+20V

RESET

I

STEREOLED
D7DB | R759
~7D | STA_DET

~
R~1!t | STI

8
~

22K

-"Nc-
R761

R752
22K

I

SYSPOWER

TAPE_MUTE

+10V_SW

5 DGND1

to TCM120 MODULE

DGND

a:
w
:;:
'"o.. '">- '"

3

TSOP1838

P709
~
~I Q
'-'

2SC1815
~
~ | R731
| 47K

22K
R753

,-----

CLK

DATA

REMOTECONTROL

RECEIVER

R73010K

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
C714 ! ~~ I
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
C701 1-~~
~W'

~
5DeC70~ R719 | 47uF+
10V, 1M | ,

~OO"H

CD_RESET

22K
IK~wv--
R710
R714

DGND

o RCIN

5 +5VD 3

+5VD

~

fY2SC1815R766
6K8

R767
-!'N-680
D711, IN4148
+

## &i~~ IK

;:
:;:
~

DGND
Cü<
DATA
STi
PLL CE
STADET
TUNER_PWR

DGND

+5VD
5 | R748 10K.
20 | R768

'-'

IC703 ~ -.... o.. | g 5
ê'5 | '" C7081+ ;g Q | '" | 10Vo ;$f§ | lU ""

RESET

R756
22K

~
3K3
0703
5 | 5,6 2SC1815

DGND

+5VDC

C7101+ D712
2u2F 5V6 50V

+ C711
2u2F
50V

1

12

## CRKD1244

## First issue 08/99

# POWER SUPPLY SCHEMATIC DIAGRAM - SCHEMA DE L'ALlMENTATION -SCHALTBILD NETZTEIL - SCHEMA DELL' ALlMENTAZIONE -

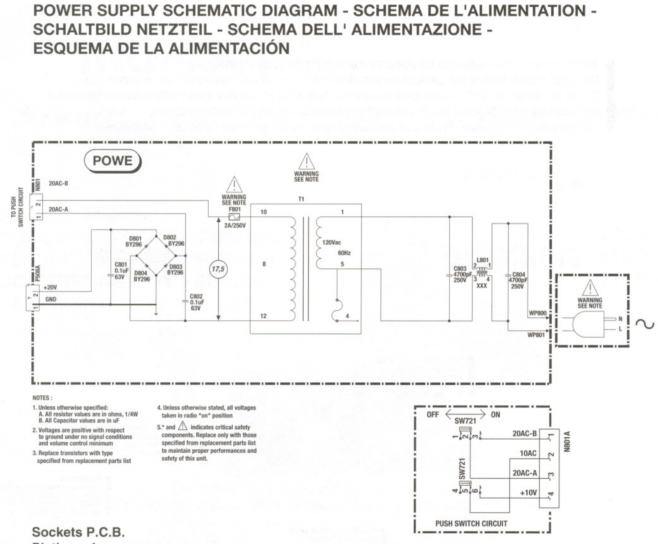
[picture p21: page 12]

# ESQUEMA DE LA ALlMENTACIÓN

'-'-'-'-'-'-'-'-'-'-'-'-'-'-'-'-'-'-'-'-'-'-'-'-'-'-' | ~
! | (POWE) | & | ! I | WARNINC | !
"ij | 2DAC-B | & | SEENDTE | I : i Z | WAR~INC | T1 | I
"
~~ | N | illNrn oiS' | 2tJAC-A | FBO1 1D | 1 | I

"
~~ - | "
~ | i | 2Al250V | !
i | 12DVac | I " | 6OHz | I
"
I.. | CBO1 | Il5 | B | C603 2LBOI, | " "$O | D.1uFDB04 | ' | = | I I~ | 63V BY296 | ~w,r 3 4 | 4f38: | -I'-'-'-'-',,!
+2tJV | XXX | 2SDV | I " | & I ~ N | CND | CB02 | " I | " D1uF | I " | WARNINC | I ~ | I | ill~ " | 12 | 4 | WPBOO"D i I | "I | ~"ru i | WPBO1"i | !
i | !'-'-'-'-'- " | I I | "
i | J NDTES:
t. Unless otherwise specitied:
A.AII resistorvalues are in ohms, 1/4W
B. Ali Capacilor values are in uF
2. Vollages are positivo with respecl
lo ground under no signal conditions and volume conlrol minimum
4. Unless olherwise staled, ali vollages lakeo in radio "on" posilion
5.' and .& | indicales critical salety
compooents. | Replace only with Ihose
specilied Irom replacemenl | parIs list
lo maintain proper periormances | and
satetyotthis | unil.

I OFF ~ | ON | I
- SW721
E"iJ | 20AC-B

10AC

!1j
Z 3. Replace transisto.. | with type
specilied Irom replacemenl | parIs lisl
20AC-A

+10V

Sockets P"C.B.

- :

## I_--"_U~~~_C~U~~ -- -J
